JAYASIMHAREDDYK/Second-Ahead/documentation/kicad_schematic_clean.png

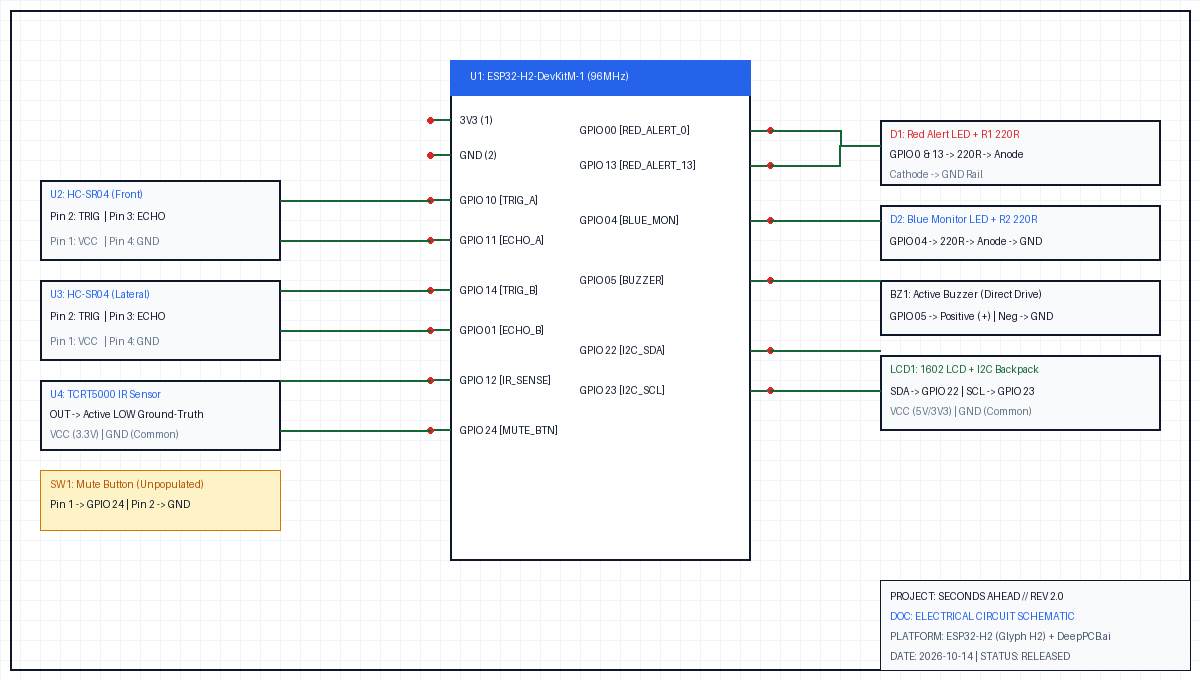
documentation/kicad_schematic_clean.png
