JAYASIMHAREDDYK/Second-Ahead/documentation/WhatsApp Image 2026-10-14 at 11.24.16 PM.jpeg

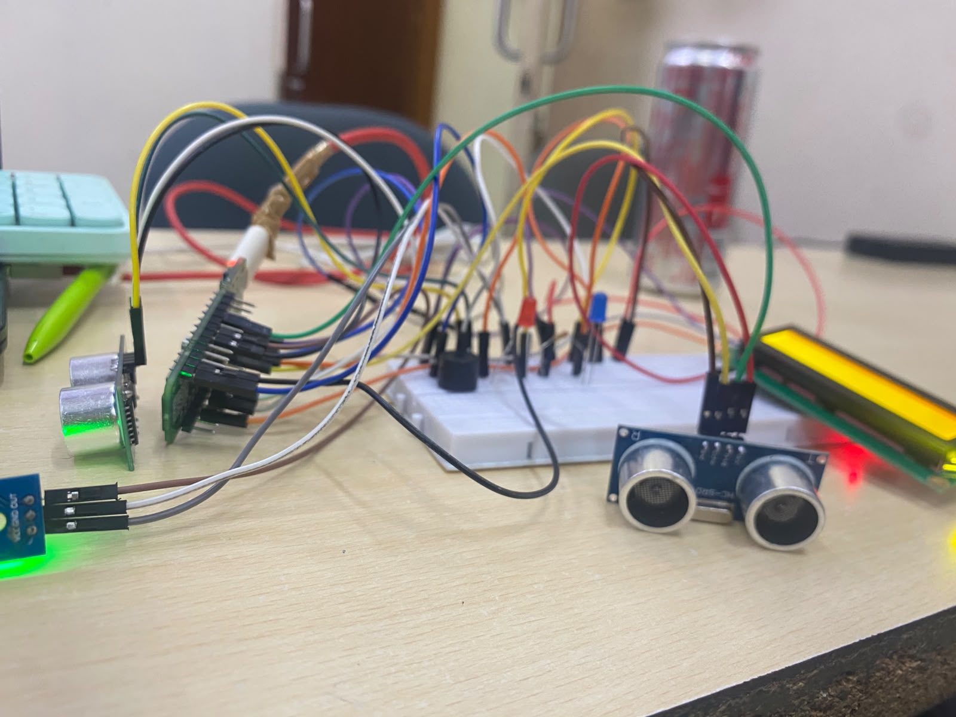
documentation/WhatsApp Image 2026-10-14 at 11.24.16 PM.jpeg
