JAYASIMHAREDDYK/Second-Ahead/kicad/seconds_ahead.kicad_pcb

## KiCad design kicad/seconds_ahead.kicad_pcb (2026-10-14)

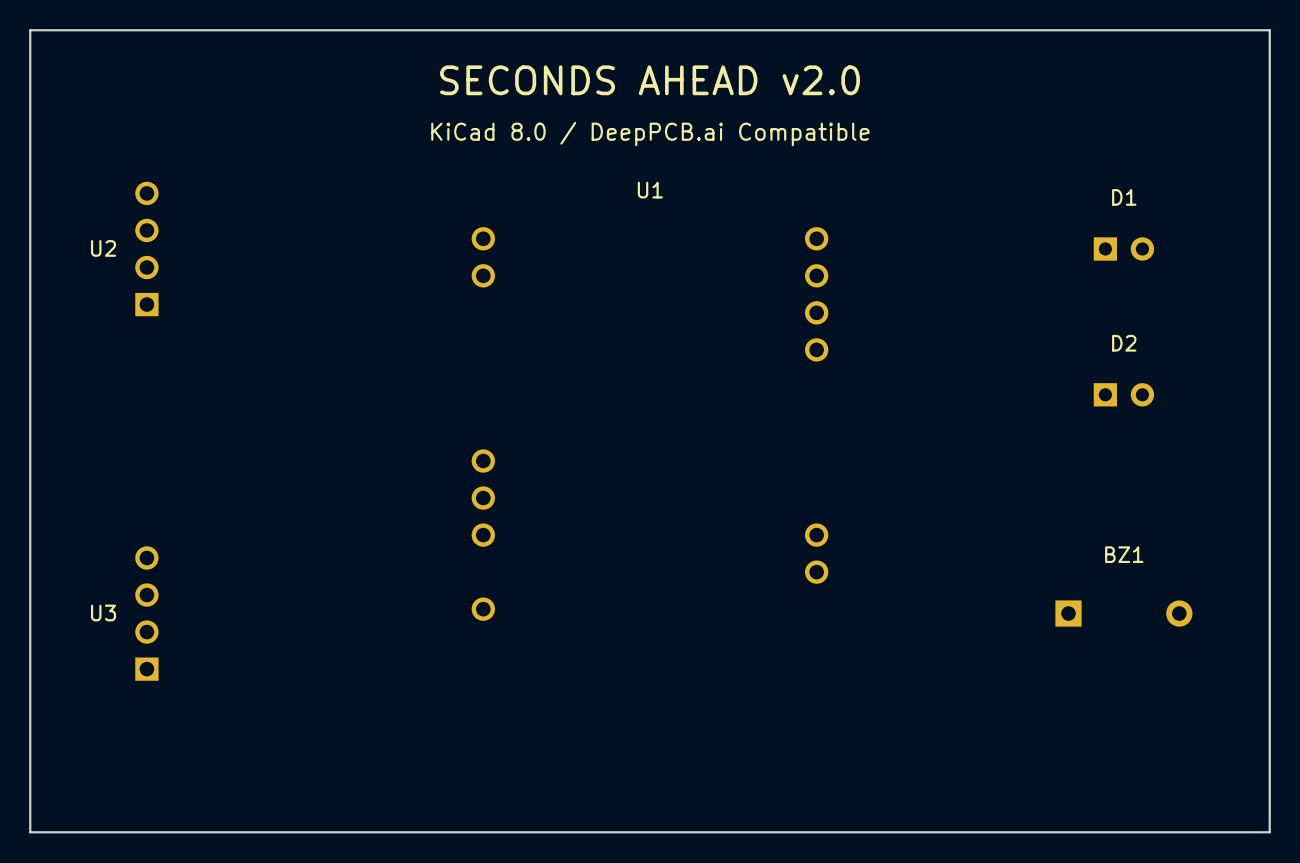
[picture p11: board seconds_ahead.kicad_pcb from above]

Board: 2 copper layers, 85.0 x 55.0 mm, 6 parts (0 on the bottom side), 8 nets, no tracks yet.

Parts:
BZ1: BUZZER; Buzzer_12x9.5RM7.6
D1: RED_ALERT; LED_D5.0mm
D2: BLUE_MONITOR; LED_D5.0mm
U1: ESP32-H2; ESP32-H2-DevKitM-1
U2: HC-SR04_FRONT; PinHeader_1x04_P2.54mm_Vertical
U3: HC-SR04_LATERAL; PinHeader_1x04_P2.54mm_Vertical

Connections:
+3V3: U1.1, U2.1, U3.1
BLUE_MONITOR: D2.1, U1.4
BUZZER_ACT: BZ1.1, U1.5
ECHO_A: U1.11, U2.3
GND: BZ1.2, D1.2, D2.2, U1.2, U2.4, U3.4
RED_ALERT: D1.1, U1.0, U1.13
TRIG_A: U1.10, U2.2
TRIG_B: U1.14, U3.2
