JAYASIMHAREDDYK/Second-Ahead/(notices)

Notices in the files:
README.md:
License: MIT
